DallasFormulaRacing/SUS/README.md

# Suspension-Sensors (SUS)
A device that is mounted near each wheel of a vehicle that can record air pressure (DLHR), acceleration, rotational speed, wheel speed and suspension travel (linear potentiometers). An ESP32 is connected to the female header (J1 & J2). This microcontroller records all inputs and send out a CAN message with all the data.

### Schematic
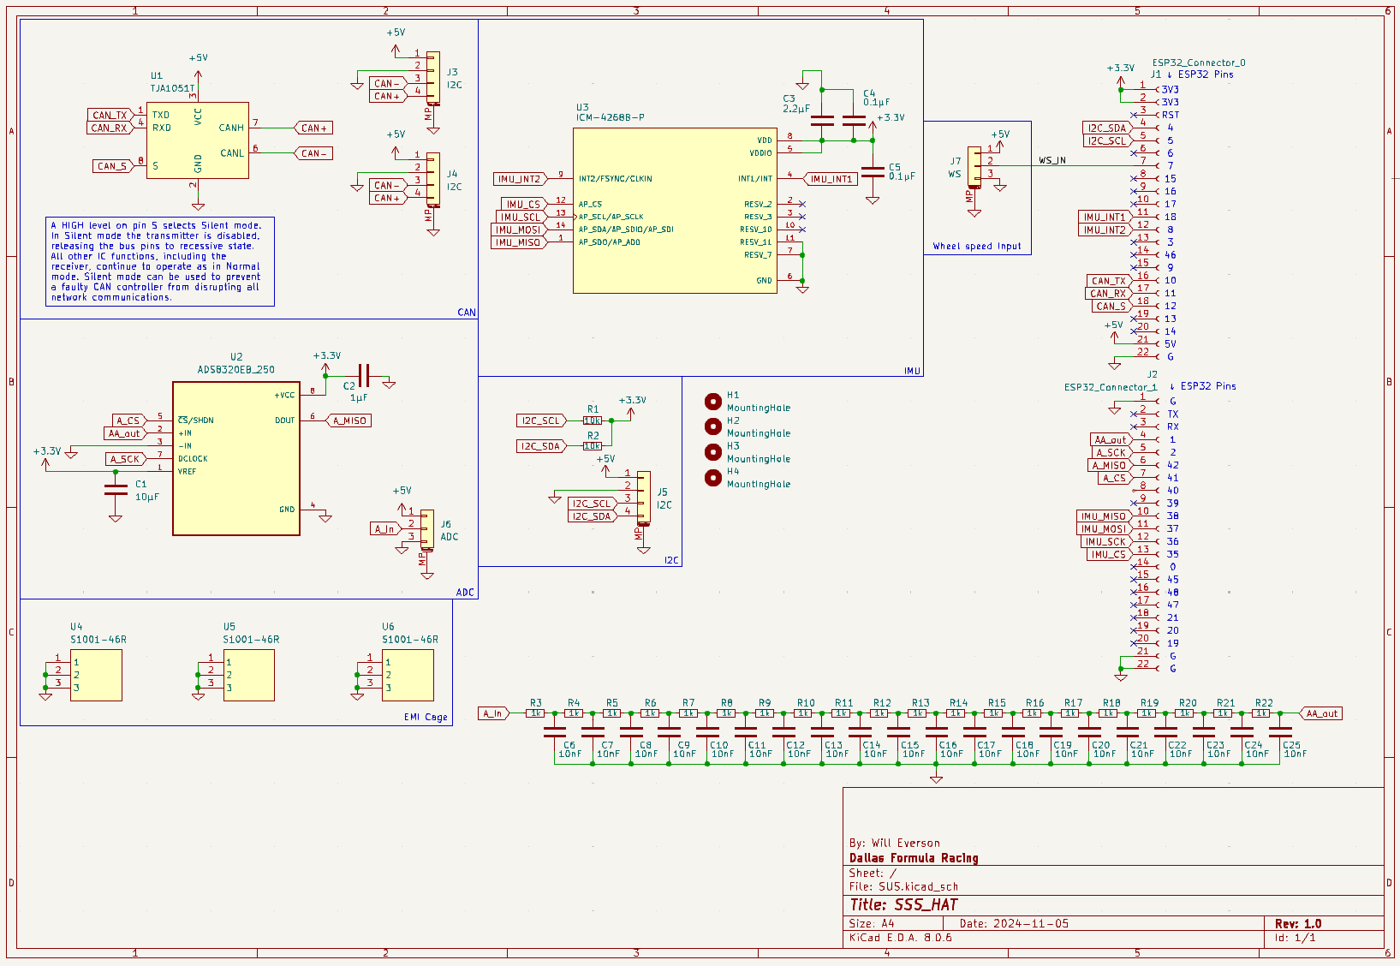
[picture p1: Images/SUS_HAT_Schematic.PNG]
ESP32 Hat Schematic

### PCB Drawing
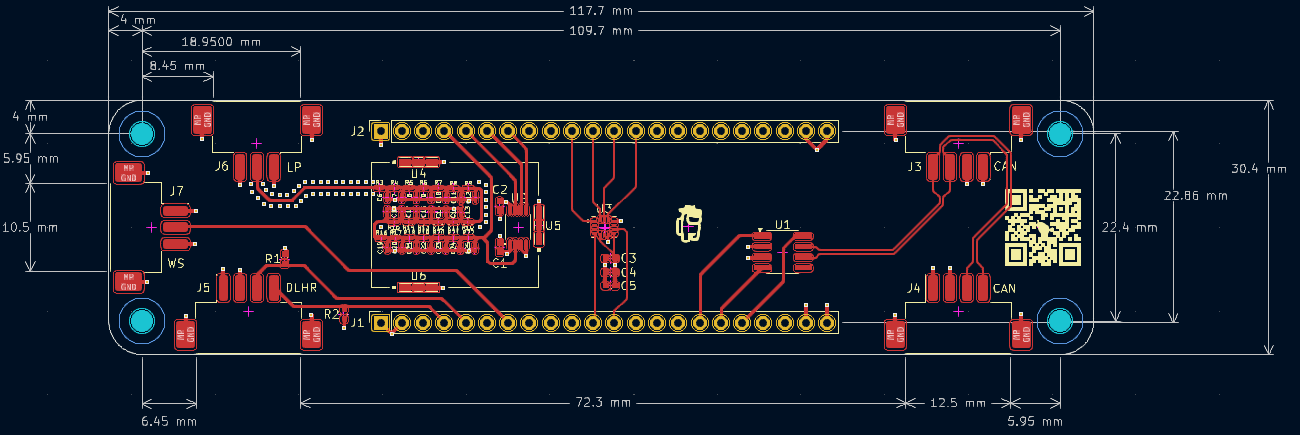
[picture p2: Images/SUS_HAT_PCB_Drawing.png]
EPS32 Hat PCB Drawing

### PCB 3D Model
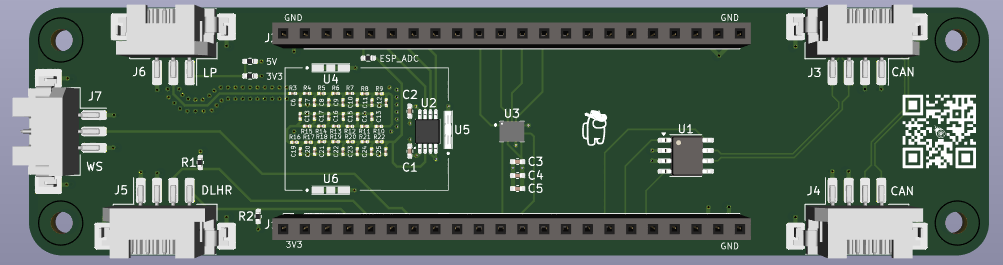
[picture p3: Images/SUS_HAT_PCB.png]

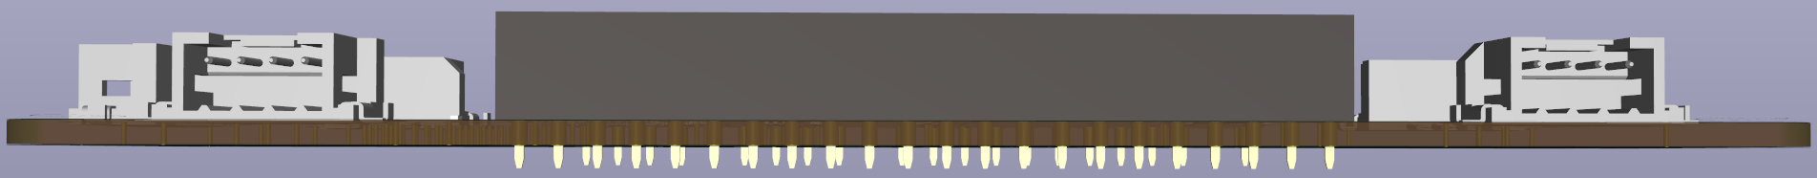
[picture p4: Images/SUS_HAT_PCB_1.png]

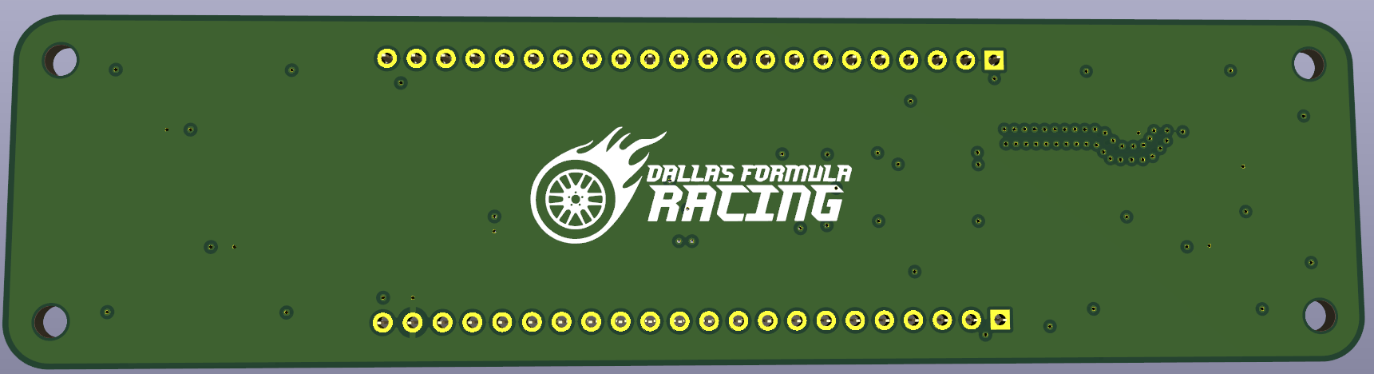
[picture p5: Images/SUS_HAT_PCB_2.png]

### Bill of Materials
|Part|Description|Photo|# of parts|Cost per part|Reference|
|:--|:--|:-:|--:|--:|--:|
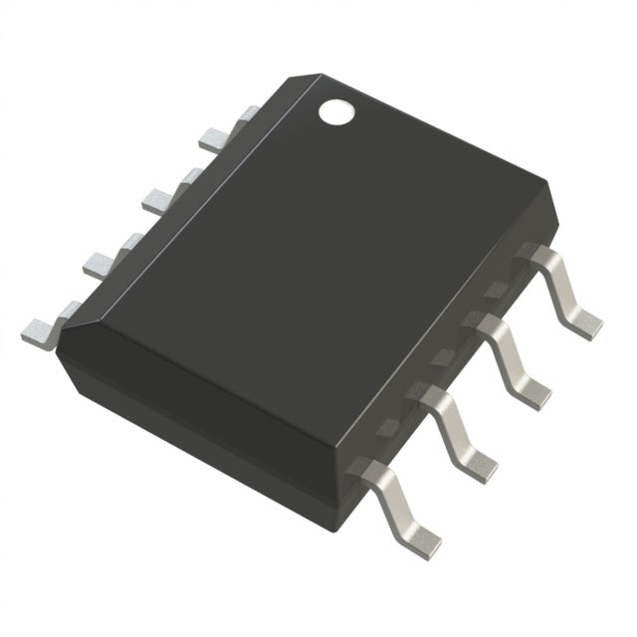
[picture p6: Images/TJA1051T.jpg]
TJA1051T
|[TJA1051T](https://www.digikey.com/en/products/detail/nxp-usa-inc/TJA1051T-3-1J/5035822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)|CAN transceiver||1|$1.22|U1|
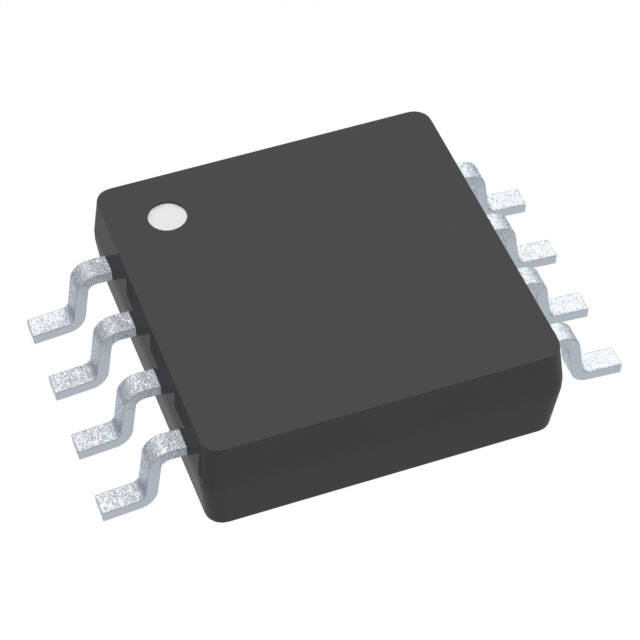
[picture p7: Images/ADS8320EB250.jpg]
ADS8320EB/250
|[ADS8320EB/250](https://www.digikey.com/en/products/detail/texas-instruments/ADS8320EB-250/275813)|External ADC||1|$14.68|U2|
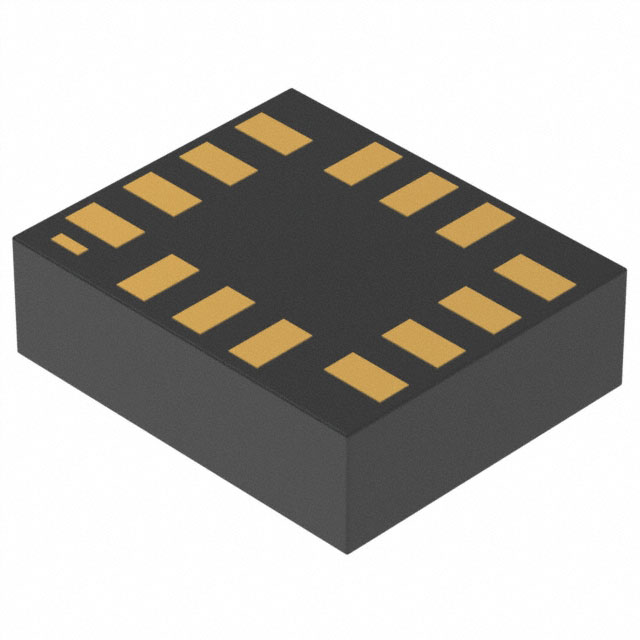
[picture p8: Images/ICM-42688-P.jpg]
ICM-42688-P
|[ICM-42688-P](https://www.digikey.com/en/products/detail/tdk-invensense/ICM-42688-P/10824934)|6-DOF IMU||1|$0.74|U3|
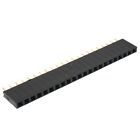
[picture p9: Images/s-l140.jpg]
1x22 2.54mm
|[1x22 2.54mm](https://www.ebay.com/itm/235072498164)|1x22 Single Row Female Straight Pin Header 2.54mm Pitch||2|$0.49|J1-J2|
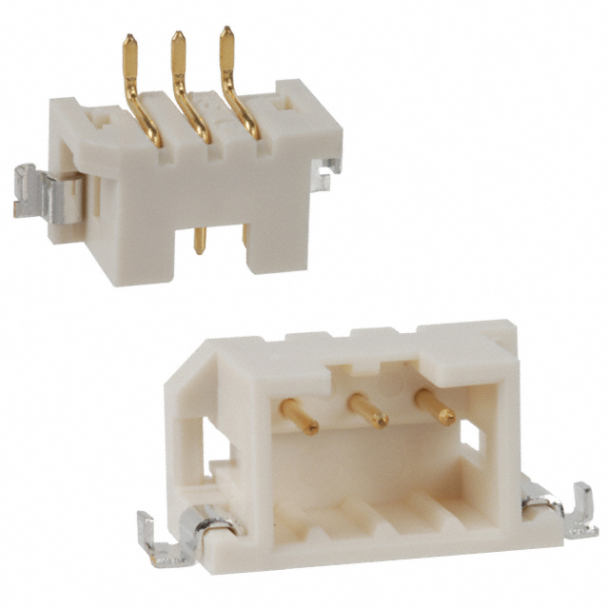
[picture p10: Images/DF3D(Z)-3P-2H(50).jpg]
DF3D(Z)-3P-2H(51)
|[DF3D(Z)-3P-2H(51)](https://www.digikey.com/en/products/detail/hirose-electric-co-ltd/DF3EA-3P-2H(51)/6148621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)|3-pin connector||2|$0.95|J6-J7|
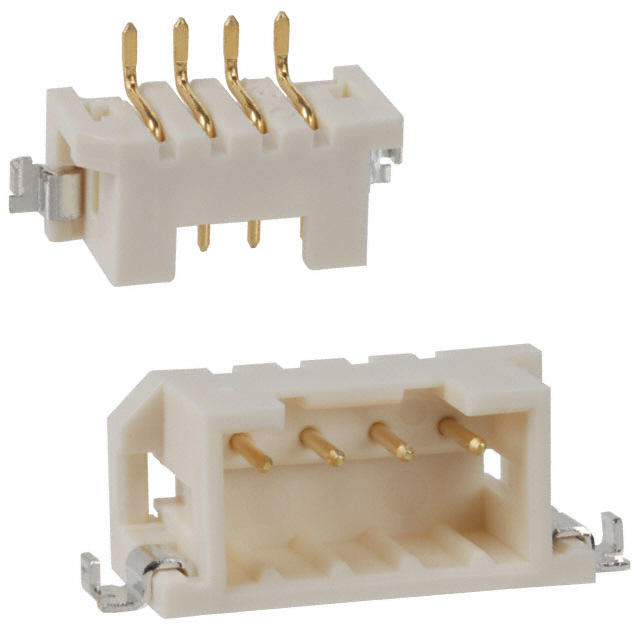
[picture p11: Images/DF3D(Z)-4P-2H(50).jpg]
DF3D(Z)-4P-2H(51)
|[DF3D(Z)-3P-2H(51)](https://www.digikey.com/en/products/detail/hirose-electric-co-ltd/DF3EA-4P-2H-51/6148543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)|4-pin connector||3|$1.08|J3-J5|
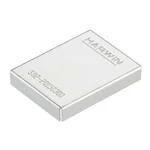
[picture p12: Images/S02-20150300.jpg]
S02-20150300
|[S02-20150300](https://www.mouser.com/ProductDetail/Harwin/S02-20150300?qs=rE7yDObIq0ygO5qZqrVEAg%3D%3D)| EMI shield | |1|$4.26|
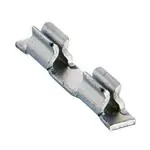
[picture p13: Images/S1001-46R.jpg]
S1001-46R
|[S1001-46R](https://www.mouser.com/ProductDetail/Harwin/S1001-46R?qs=HTI7V3DFux8iE7nFrNF%2Fww%3D%3D)| EMI shield connectors ||3|$0.58|U4-U6|
|10nF Capacitor|10nF 0201||20||C6-C25|
|0.1μF Capacitor|0.1μF 0402 Hand Solder||2||C4-C5|
|1μF Capacitor|1μF 0402 Hand Solder||1||C2|
|2.2μF Capacitor|2.2μF 0402 Hand Solder||1||C3|
|10μF Capacitor|10μF 0402 Hand Solder||1||C1|
|1kΩ Resistor|1kΩ 0201||20||R3-R22|
|10kΩ Resistor|10kΩ 0402||2||R1-R2|

#### Female connectors (AWG 24 - 28)
|Part|Description|Photo|# of parts|Cost per part|
|:--|:--|:-:|--:|--:|
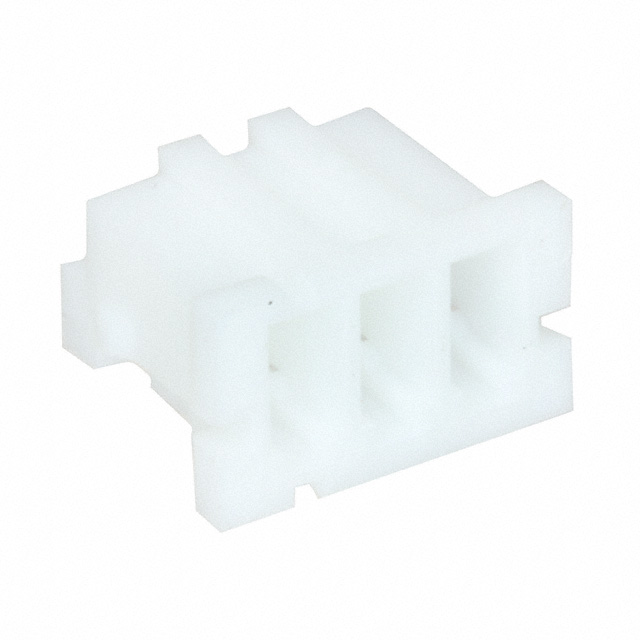
[picture p14: Images/DF3-3S-2C(10).jpg]
DF3-3S-2C(10)
|[DF3-3S-2C(10)](https://www.digikey.com/en/products/detail/hirose-electric-co-ltd/DF3-3S-2C-10/3977787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)|3POS 2.00MM connector||2|$0.071|
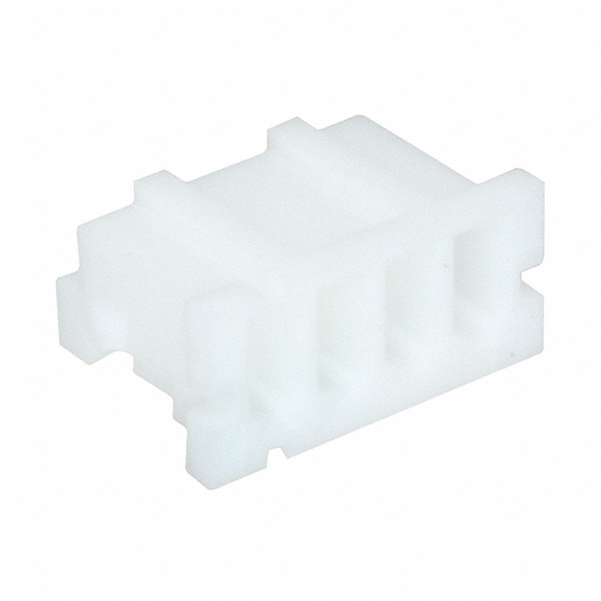
[picture p15: Images/DF3-4S-2C(10).jpg]
DF3-4S-2C(10)
|[DF3-4S-2C(10)](https://www.digikey.com/en/products/detail/hirose-electric-co-ltd/DF3-4S-2C-10/4282726)|4POS 2.00MM connector||3|$0.071|
