DallasFormulaRacing/SUS/SUS/production/bom.csv

Designator | Footprint | Quantity | Value | LCSC Part #
C1 | 0402 | 1 | 10μF
C10, C11, C12, C13, C14, C15, C16, C17, C18, C19, C20, C21, C22, C23, C24, C25, C6, C7, C8, C9 | 0201 | 20 | 10nF
C2 | 0402 | 1 | 1μF
C3 | 0402 | 1 | 2.2μF
C4, C5 | 0402 | 2 | 0.1μF
R1, R2 | 0402 | 2 | 10k
R10, R11, R12, R13, R14, R15, R16, R17, R18, R19, R20, R21, R22, R3, R4, R5, R6, R7, R8, R9 | 0201 | 20 | 1k
R23, R24, R27 | 0402 | 3 | 0
U3 | ICM-42688-P | 1 | ICM-42688-P
