DallasFormulaRacing/SUS/SUS/Footprints/ADC/DGK0008A.stp

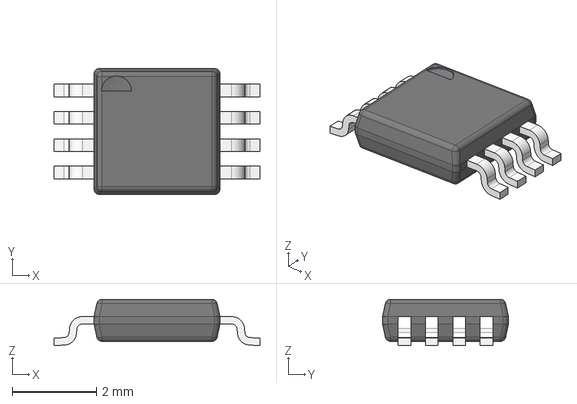
[picture p33: CAD file, 2024-11-06]
SUS/Footprints/ADC/DGK0008A.stp
4.90 x 3.00 x 1.10 mm
BODY_MUA08A
LEAD_MUA08A x 8
