DallasFormulaRacing/SUS/SUS/Footprints/Connectors/DF3EA-3P-2H(51).STEP

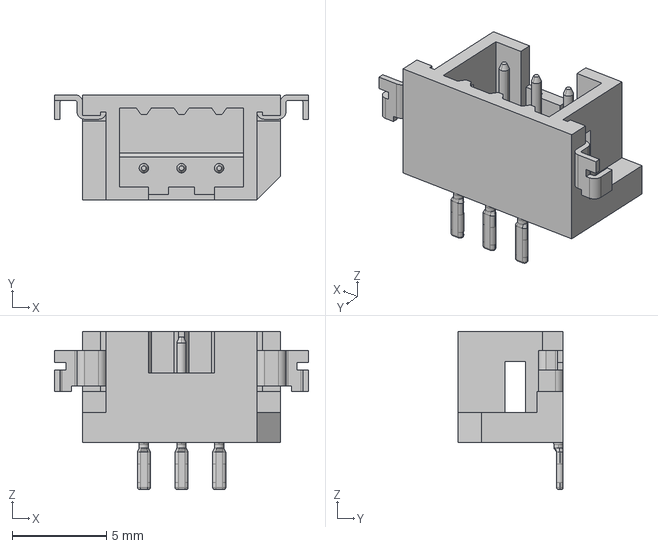
[picture p34: CAD file, 2024-11-06]
SUS/Footprints/Connectors/DF3EA-3P-2H(51).STEP
13.5 x 5.60 x 8.40 mm
