DallasFormulaRacing/SUS/SUS/Footprints/Faraday Cage/S1001-46R/S1001-46R.stp

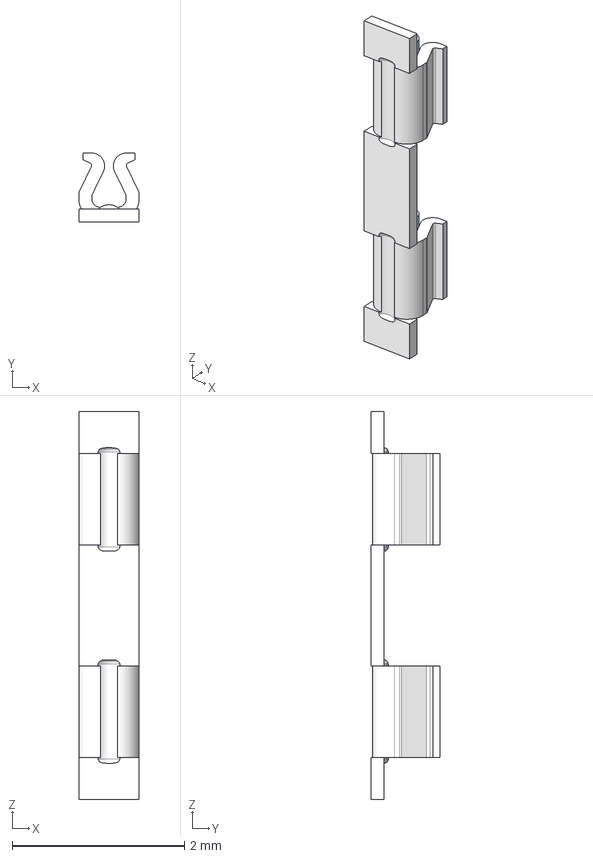
[picture p35: CAD file, 2024-11-06]
SUS/Footprints/Faraday Cage/S1001-46R/S1001-46R.stp
0.7 x 0.8 x 4.50 mm
