DallasFormulaRacing/SUS/SUS/Footprints/Connectors/DF3EA-4P-2H(24).STEP

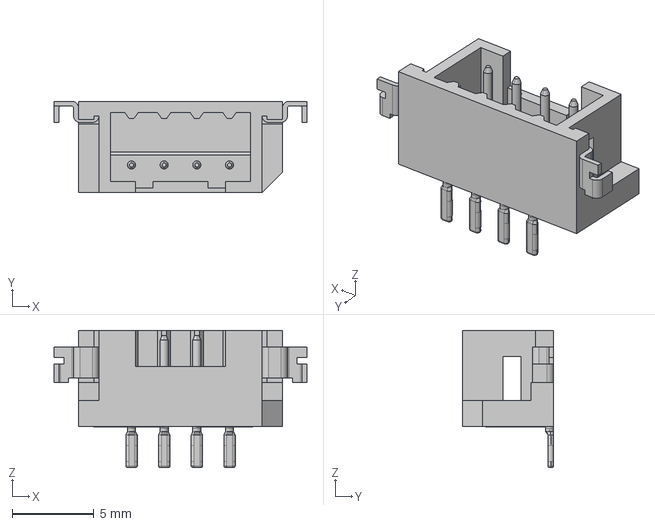
[picture p36: CAD file, 2024-11-06]
SUS/Footprints/Connectors/DF3EA-4P-2H(24).STEP
15.5 x 5.60 x 8.40 mm
