DallasFormulaRacing/SUS/SUS/SUS.kicad_pcb

## KiCad design SUS/SUS.kicad_pcb (2024-11-15)

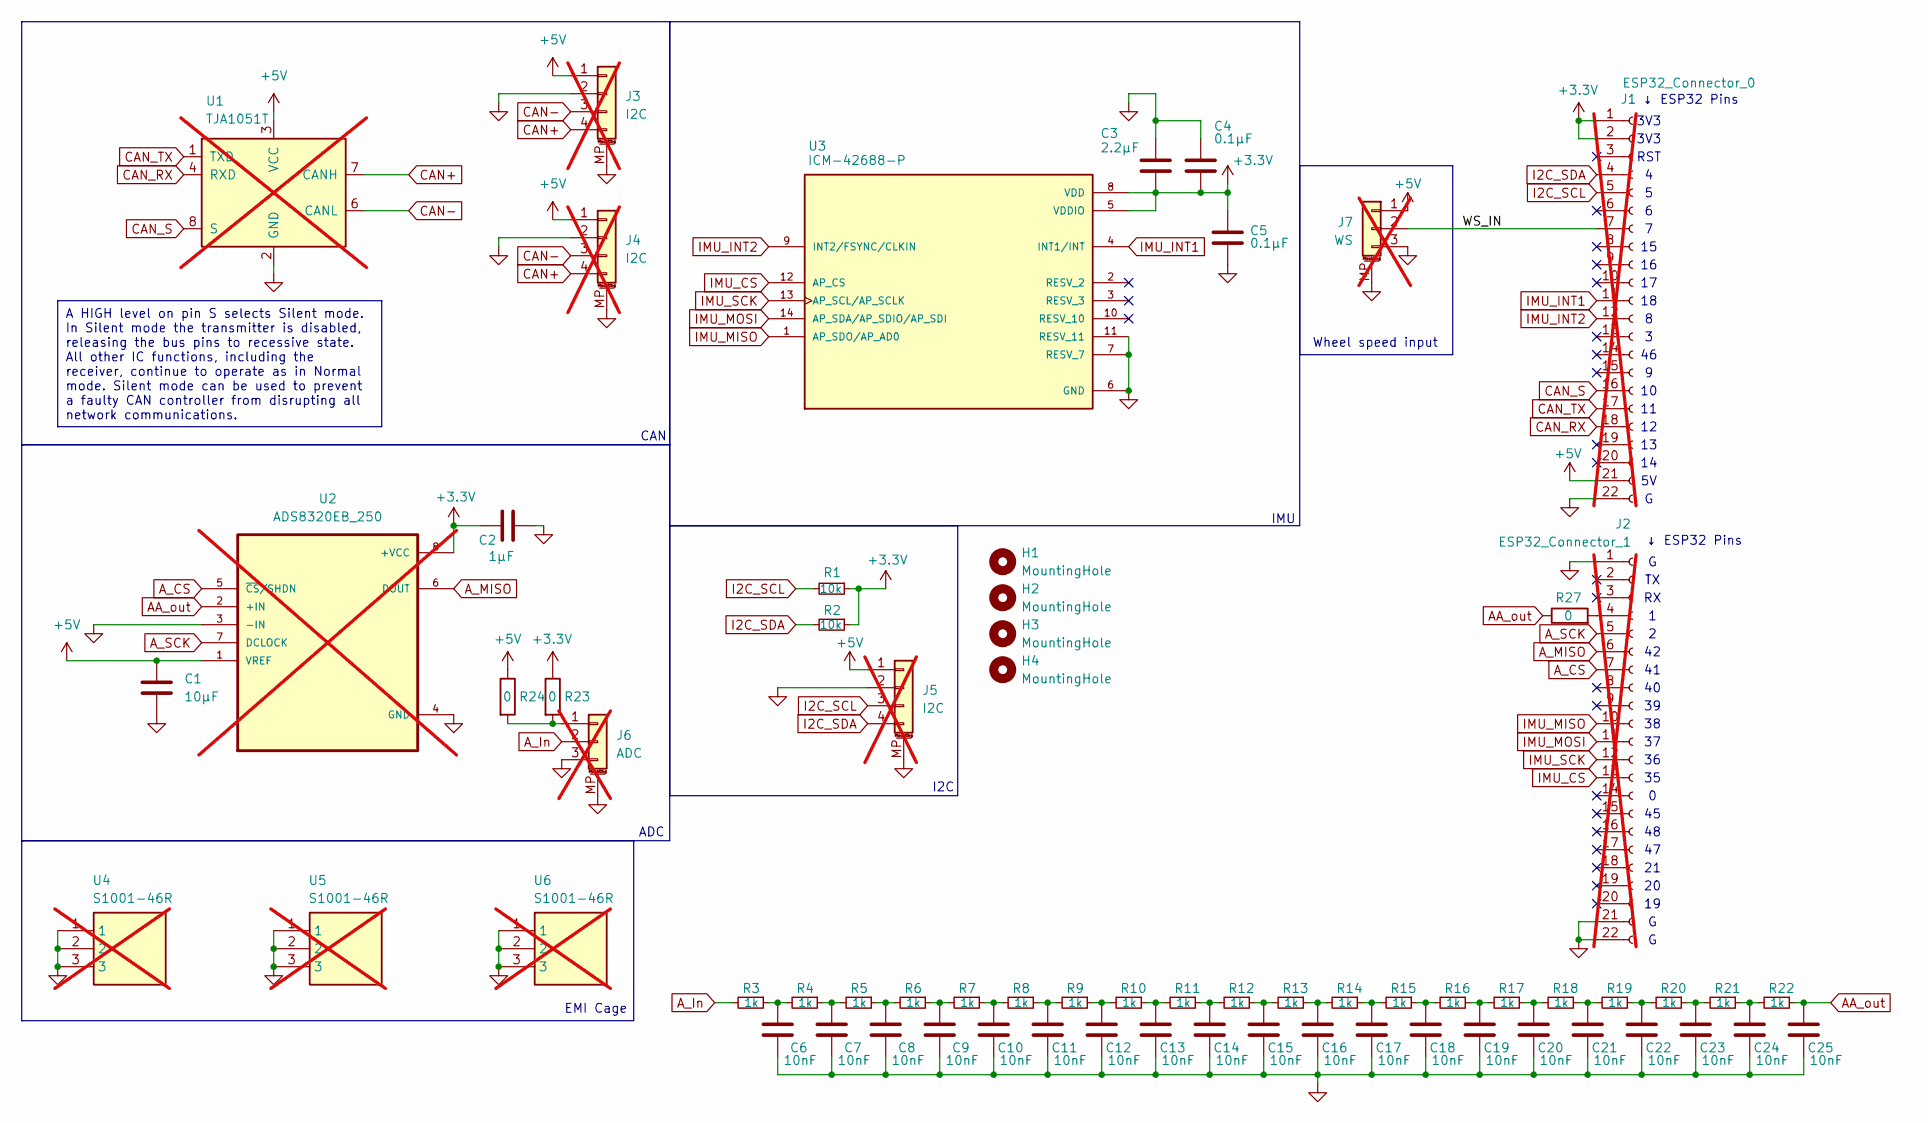
[picture p37: schematic SUS.kicad_sch, SSS_HAT]

Parts:
C1: 10μF; C_0402_1005Metric_Pad0.74x0.62mm_HandSolder
C2: 1μF; C_0402_1005Metric_Pad0.74x0.62mm_HandSolder
C3: 2.2μF; C_0402_1005Metric_Pad0.74x0.62mm_HandSolder
C4, C5: 0.1μF; C_0402_1005Metric_Pad0.74x0.62mm_HandSolder
C6, C7, C8, C9, C10, C11, C12, C13, C14, C15, C16, C17, C18, C19, C20, C21, C22, C23, C24, C25: 10nF; C_0201_0603Metric; LCSC PN C76941
H1, H2, H3, H4: MountingHole; MountingHole_2.7mm_M2.5
J1: ESP32_Connector_0; PinSocket_1x22_P2.54mm_Vertical; not fitted
J2: ESP32_Connector_1; PinSocket_1x22_P2.54mm_Vertical; not fitted
J3, J4, J5: I2C; Hirose_DF3EA-04P-2H_1x04-1MP_P2.00mm_Horizontal; not fitted
J6: ADC; Hirose_DF3EA-03P-2H_1x03-1MP_P2.00mm_Horizontal; not fitted
J7: WS; Hirose_DF3EA-03P-2H_1x03-1MP_P2.00mm_Horizontal; not fitted
R1, R2: 10k; R_0402_1005Metric_Pad0.72x0.64mm_HandSolder; JLCpart# C2906988
R3, R4, R5, R6, R7, R8, R9, R10, R11, R12, R13, R14, R15, R16, R17, R18, R19, R20, R21, R22: 1k; C_0201_0603Metric; LCSC PN C270365
R23, R24, R27: 0; R_0402_1005Metric_Pad0.72x0.64mm_HandSolder
U1: TJA1051T; SOIC-8_3.9x4.9mm_P1.27mm; JLCpart# C38695; not fitted
U2: ADS8320EB_250; DGK0008A_L; not fitted
U3: ICM-42688-P; PARTREV 1.2; LCSC PN C1850418
U4, U5, U6: S1001-46R; S100146R; Mouser Part Number 855-S1001-46R; not fitted

Connections:
+3.3V: C2.1, C3.2, C4.2, C5.1, J1.1, J1.2, R1.1, R2.1, R23.1, U2.8 (+VCC), U3.5 (VDDIO), U3.8 (VDD)
+5V: C1.1, J1.21, J3.1, J4.1, J5.1, J7.1, R24.1, U1.3 (VCC), U2.1 (VREF)
/WS_IN: J1.7, J7.2
AA_out: C25.2, R22.1, R27.1, U2.2 (+IN)
A_CS: J2.7, U2.5 (~CS/SHDN)
A_In: J6.2, R3.2
A_MISO: J2.6, U2.6 (DOUT)
A_SCK: J2.5, U2.7 (DCLOCK)
CAN+: J3.4, J4.4, U1.7 (CANH)
CAN-: J3.3, J4.3, U1.6 (CANL)
CAN_RX: J1.18, U1.4 (RXD)
CAN_S: J1.16, U1.8 (S)
CAN_TX: J1.17, U1.1 (TXD)
GND: C1.2, C2.2, C3.1, C4.1, C5.2, C6.1, C7.1, C8.1, C9.1, C10.1, C11.1, C12.1, C13.1, C14.1, C15.1, C16.1, C17.1, C18.1, C19.1, C20.1, C21.1, C22.1, C23.1, C24.1, C25.1, J1.22, J2.1, J2.21, J2.22, J3.2, J3.MP (MountPin), J4.2, J4.MP (MountPin), J5.2, J5.MP (MountPin), J6.3, J6.MP (MountPin), J7.3, J7.MP (MountPin), U1.2 (GND), U2.3 (-IN), U2.4 (GND), U3.6 (GND), U3.7 (RESV_7), U3.11 (RESV_11), U4.1, U4.2, U4.3, U5.1, U5.2, U5.3, U6.1, U6.2, U6.3
I2C_SCL: J1.5, J5.3, R1.2
I2C_SDA: J1.4, J5.4, R2.2
IMU_CS: J2.13, U3.12 (AP_CS)
IMU_INT1: J1.11, U3.4 (INT1/INT)
IMU_INT2: J1.12, U3.9 (INT2/FSYNC/CLKIN)
IMU_MISO: J2.10, U3.1 (AP_SDO/AP_AD0)
IMU_MOSI: J2.11, U3.14 (AP_SDA/AP_SDIO/AP_SDI)
IMU_SCK: J2.12, U3.13 (AP_SCL/AP_SCLK)
unnamed: C6.2, R3.1, R4.2
unnamed: C7.2, R4.1, R5.2
unnamed: C8.2, R5.1, R6.2
unnamed: C9.2, R6.1, R7.2
unnamed: C10.2, R7.1, R8.2
unnamed: C11.2, R8.1, R9.2
unnamed: C12.2, R9.1, R10.2
unnamed: C13.2, R10.1, R11.2
unnamed: C14.2, R11.1, R12.2
unnamed: C15.2, R12.1, R13.2
unnamed: C16.2, R13.1, R14.2
unnamed: C17.2, R14.1, R15.2
unnamed: C18.2, R15.1, R16.2
unnamed: C19.2, R16.1, R17.2
unnamed: C20.2, R17.1, R18.2
unnamed: C21.2, R18.1, R19.2
unnamed: C22.2, R19.1, R20.2
unnamed: C23.2, R20.1, R21.2
unnamed: C24.2, R21.1, R22.2
unnamed: J2.4, R27.2
unnamed: J6.1, R23.2, R24.2

Notes on the sheet:
A HIGH level on pin S selects Silent mode. In Silent mode the transmitter is disabled, releasing the bus pins to recessive state. All other IC functions, including the receiver, continue to operate as in Normal mode. Silent mode can be used to prevent a faulty CAN controller from disrupting all net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
EMI Cage
↓ ESP32 Pins
3V3
ADC
I2C
Wheel speed input
CAN
IMU
RST

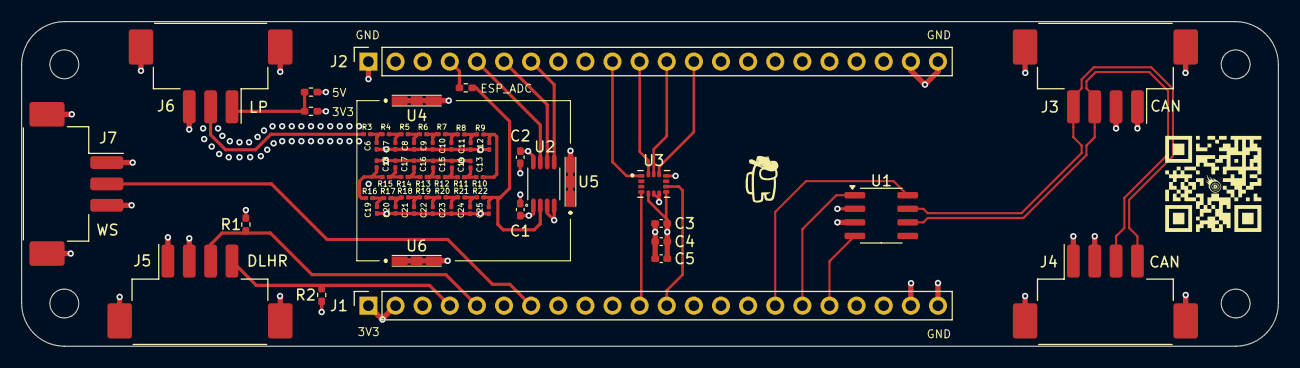
[picture p38: board SUS.kicad_pcb from above]

Board: 4 copper layers, 117.7 x 30.4 mm, 67 parts (0 on the bottom side), 43 nets.
