DallasFormulaRacing/SUS/(commit log)

2024-10-22 PCB Schematic Upload
    [SSS_HAT.kicad_pcb, SSS_HAT.kicad_sch]
2024-10-22 Changed file organization
    [SSS_HAT.kicad_pcb, SSS_HAT.kicad_sch]
2024-10-22 Added 2 CAN buses and 2 I2C buses
    [SSS_HAT.kicad_pcb, SSS_HAT.kicad_sch]
2024-10-23 Removed 1 I2C bus & 1 CAN transciever
    [SSS_HAT.kicad_sch]
2024-10-23 Added 2 Channel 18-bit ADC
    [SSS_HAT.kicad_pcb, SSS_HAT.kicad_sch]
2024-10-23 added IMU
    [SSS_HAT.kicad_pcb, SSS_HAT.kicad_sch]
2024-10-24 Routed PCB & Replaced IMU for ICM-42688-P
    [1x3_Molex_Nano-Fit.stp, 1x4_Molex_Nano-Fit.stp, ICM-42688-P.step, SSS_HAT.kicad_pcb, SSS_HAT.kicad_sch]
2024-10-24 Changed a few traces and added measurements to PCB drawing
    [SSS_HAT.kicad_pcb, SSS_HAT.kicad_sch]
2024-10-24 A few minor layout changes
    [SSS_HAT.kicad_pcb]
2024-10-24 Changed PCB drawing size & updated README.md images
    [SSS_HAT.kicad_pcb]
2024-10-24 Fixed PCB drawing
2024-10-24 Added DFR logo and fixed GND connections
    [SSS_HAT.kicad_pcb]
2024-10-29 Added ADS8320EB/250 ADC
    [ADS8320EB_250.step, SSS_HAT.kicad_pcb, SSS_HAT.kicad_sch]
2024-10-31 Replaced ADC for ADS8320EB-250, changed molex connectors to hirose connectors and re-routed PCB
    [1x3_Molex_Nano-Fit.stp, 1x4_Molex_Nano-Fit.stp, ADS8320EB_250.step, DGK0008A.stp, ICM-42688-P.step, SSS_HAT.kicad_pcb]
2024-10-31 Updated 3D model & readme.
    [DF3EA-3P-2H(51).STEP, DF3EA-4P-2H(24).STEP, ICM-42688-P.step, SSS_HAT.kicad_pcb, SSS_HAT.kicad_sch]
2024-10-31 Edited Readme.md and added to silkscreen
2024-11-05 Fixed J1 & J2 footprints which called for an entire re-route
    [SSS_HAT.kicad_sch]
2024-11-06 added updates from 11/5 meeting. Faraday cage WIP
    [SSS_HAT.kicad_pcb]
2024-11-06 Changed the layout of a few compoenents, added EMI cage & updated README.md
    [DF3EA-3P-2H(51).STEP, DF3EA-4P-2H(24).STEP, DGK0008A.stp, ICM-42688-P.step, S1001-46R.stp, SUS.kicad_pcb, SUS.kicad_sch]
2024-11-06 Changed ESP32 analog pin
    [SUS.kicad_pcb, SUS.kicad_sch]
2024-11-07 Re-reouted wheel speed signal line
    [SUS.kicad_pcb]
2024-11-07 Fixed width of wheel speed data line
    [SUS.kicad_pcb]
2024-11-07 Minor fixes & generated fabrication files
    [SUS.kicad_pcb, SUS.kicad_sch, bom.csv, designators.csv, positions.csv]
2024-11-07 Updated trace names & README.md
    [SUS.kicad_sch]
2024-11-07 Minor fixes
    [SUS.kicad_sch]
2024-11-08 added pads to connect 3.3v or 5v to lin pots & other last minute changes
    [SUS.kicad_pcb, SUS.kicad_sch, bom.csv, designators.csv, positions.csv]
2024-11-15 Removed Vias
    [DF3EA-3P-2H(51).STEP, DF3EA-4P-2H(24).STEP, DGK0008A.stp, ICM-42688-P.step, S1001-46R.stp, SUS.kicad_pcb, SUS.kicad_sch]
2024-11-15 updated production files
    [SUS.kicad_pcb, bom.csv, positions.csv]
